autonomous-robot-competition2019/Team-Red/code/test-code/milestone_4_5_6/light_test/light_test.ino

/*
  Test sketch for the Adafruit Analog Light Sensor
  by Bill Earl
  for Adafruit Industries
  
  Connect sensor output to Analog Pin 0
  Connect 5v to VCC and GND to GND
  Connect 3.3v to the AREF pin 
 */

int lightPin = A8;    // select the input pin for the potentiometer

float rawRange = 1024; // 3.3v
float logRange = 5.0; // 3.3v = 10^5 lux

void setup() 
{
  analogReference(EXTERNAL); //
  Serial.begin(9600);
  Serial.println("Adafruit Analog Light Sensor Test");
}

void loop() 
{
  // read the raw value from the sensor:
  int rawValue = analogRead(sensorPin);    
  
  Serial.print("Raw = ");
  Serial.print(rawValue);
  Serial.print(" - Lux = ");
  Serial.println(RawToLux(rawValue)); 
  delay(1000);
}

float RawToLux(int raw)
{
  float logLux = raw * logRange / rawRange;
  return pow(10, logLux);
}
