autonomous-robot-competition2019/Team-Red/(commit log)

2019-03-03 Updated motor and rotation function
2019-03-25 Updated rotation and switched motors for new chassis
2019-03-26 Added light sensor stopping
2019-03-27 added test code for arm
2019-03-27 added claw support
2019-03-28 Added basic arm functonality
2019-04-03 Removed light sensor function
2019-04-04 Updated code for new chassis
2019-04-05 Updated to fix tracking
    [pixycam_test.ino, rgbtest.ino]
